david7lanci/traffic_light/arduino_video.pptx

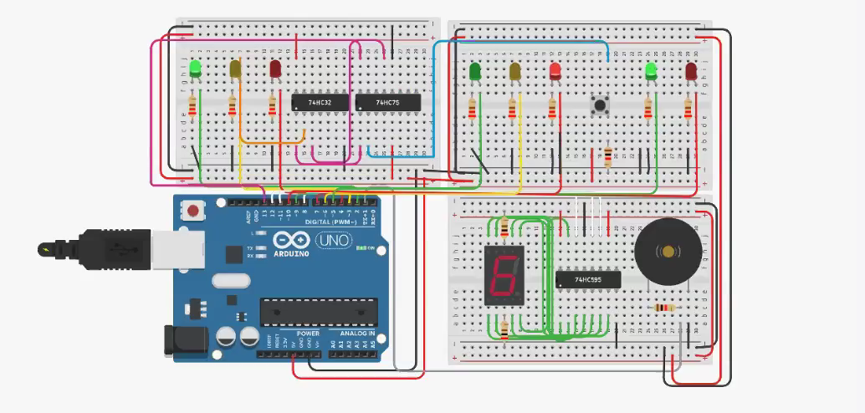
[picture p1: figure]
