david7lanci/traffic_light/book project.pdf

# קדם פרויקט

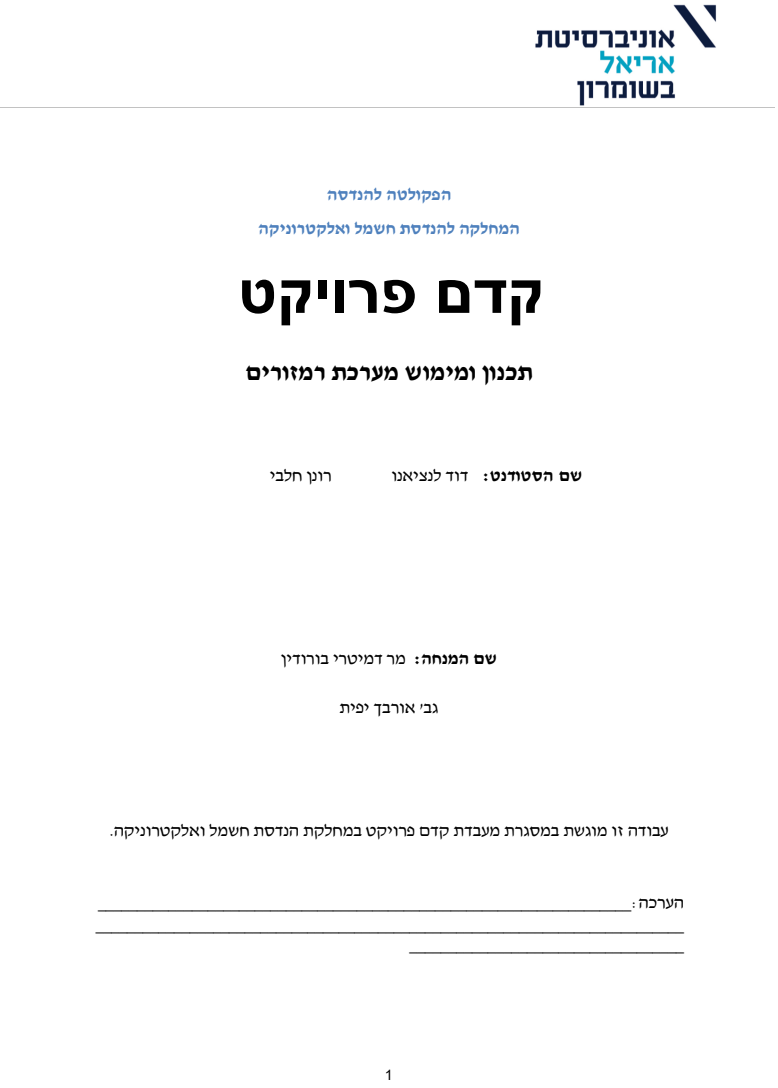
[picture p2: page 1]
הפקולטה להנדסה; הערכה:____________________________________________________________________ ___________________________________________________________________________ ___________________________________; daTg Thetford

המחלקה להנדסת חשמל ואלקטרוניקה

תכנון ומימוש מערכת רמזורים

שם הסטודנט: דוד לנציאנו רונן חלבי

שם המנחה: מר דמיטרי בורודין

גב' אורבך יפית

עבודה זו מוגשת במסגרת מעבדת קדם פרויקט במחלקת הנדסת חשמל ואלקטרוניקה.

### תוכן עניינים

16 | D-latch (NAND Gates) 4.4.1
18 | Seven segment 4.6.3
19 |

פרק :1 מבוא

1.1 רקע תיאורטי

רמזורים הם מערכת אורות צבעוניים המוצבת בצמתים, ותפקידם לווסת את התנועה בצומת. הרמזור הוא סוג של תמרור .
רמזורים לנסיעה למכוניות - לרמזורים למכוניות ישנם שלושה צבעים המסודרים אחד מעל השני)ירוק, צהוב ואדום(. האור הירוק מסמל שהנוסע רשאי לחצות את הצומת. האור הצהוב מסמל שהרמזור עומד להתחלף לאדום ולכן יש לפנות את הצומת והאור האדום מסמל לנוסע לעצור את נסיעתו ולא לעבור את הצומת. רמזורים להולכי רגל - רמזורים להולכי רגל עשויים להיות במצב המתיר חצייה, בזמן שגם מכוניות מסוימות מורשות לעבור. במצבים כאלו, זכות הקדימה נתונה להולכי הרגל. האור הירוק - מסמל שאפשר לחצות בעוד האור האדום - מסמל שאין לחצות.

איור .1רמזורים לנסיעה למכוניות.

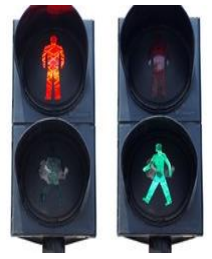
[picture p3: figure]

i | איור .2 רמזורים להולכי רגל

1.2 מדוע יש להפחית בעומסי התנועה ולמזער תאונות?

פקקי תנועה בישראל גורמים נזק של עשרות מיליארדי שקלים בשנה. בשנת 2016 העריכו משרד האוצר, משרד התחבורה וגופי התכנון כי פקקי תנועה עולים למשק 35 מיליארד ש"ח בשנה, וכי ללא שינוי המצב הקיים, העלות תגיע ל70- מיליארד ש"ח בשנה עד שנת .2040 כמות הנסועה בכלי רכב ממונעים )במיליוני ק"מ בשנה( לעומת אורך הכבישים בישראל )בק"מ(. עם השנים יש פער גדל בין כמות הנסועה לבין כמות הכבישים. הפער גדול יותר כאשר בודקים את היחס בין כמות הנסועה במכוניות לעומת כמות הכבישים העירוניים שבהם עיקר עומסי התנועה.
עומסי תנועה הן אחת ההשפעות החיצוניות היקרות והנפוצות של הרכב הפרטי, בישראל נהגים מבלים בפקקים מיליוני שעות עבודה ופנאי בשנה, דבר שפוגע הן ברווחה החברתית באופן ישיר, הן בהון החברתי והן בתוצר הכלכלי של המשק, בעלות של מיליארדי שקלים בשנה. בנוסף עומסי התנועה גורמים לאיחורים לא צפויים, מעלים את זיהום אוויר מתחבורה במיוחד במרכז הערים, גורמים לבלאי מואץ במכוניות ולבזבוז דלק, ותורמים לבעיות בריאות כמו מתח נפשי וגופני )סטרס(, כאבי גב וצוואר, התנהגות פרועה של נהגים עצבניים ) Road rage, נהגים שאיחרו ומנסים להגיע בזמן(, ולתת פעילות גופנית. באופן זה לפקקים יש השפעות גבוהות על רווחה חברתית בישראל והם מחריפים את משבר הבריאות בישראל על
ii | ידי תוספת של תחלואה, נכות ותמותה

1.3 הצורך בפתרון

הדרך שבה יהיה ניתן להפחית מעומסי התנועה הינה על ידי תכנון מערכת רמזורים אשר תהיה יציבה ובטיחותית כלפי המכוניות והולכי הרגל ואף שימושית לאנשים בעלי לקות ראייה.
הרמזור מהווה את אחד האמצעים החשובים לשפור זרימת התנועה ולקיום משטר תנועה תקין ובטוח.

פרק 2 :מטרת הפרויקט

מטרת הפרויקט הינה תכנון ומימוש של מערכת רמזורים לצומת T המתוארת באיור הבא:

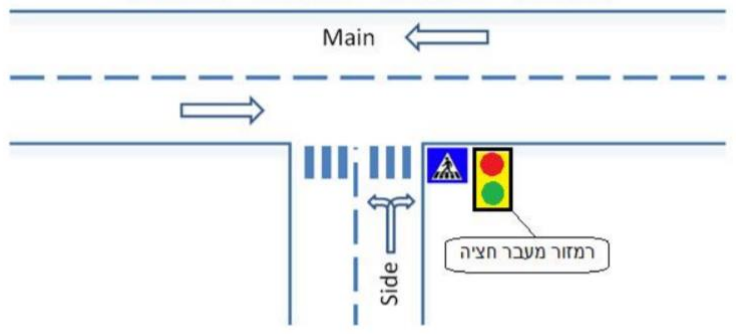
[picture p4: figure]

iii | איור .3 צומת הרמזורים

הצומת מורכבת משני צירים - ציר ראשי וציר משני הכולל מעבר חצייה להולכי רגל, כאשר הצירים כוללים שלושה רמזורים בהתאמה, העובדים במצבים המתוארים באיור 2)רמזור הולכי הרגל מתואם עם הרמזור המשני(.

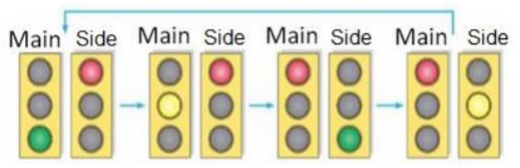
[picture p5: figure]

איור .4 מצבי הרמזורים הראשי והמשני.
המערכת כוללת תצוגה של ספירה לאחור עבור הולכי רגל וצפצוף בתדר משתנה לפי מצב הרמזור.

2.1 דרישות המערכת

- המערכת עוברת בין מצבים שונים בעלי אורך זמן משתנה.
- המערכת בעלת צפצוף בשני תדרים שונים במעבר הולכי רגל כדי לשמש אנשים בעלי לקות ראייה.
- צג זמן אשר מראה על ידי ספירה לאחור כמה זמן נותר להולך רגל לעבור את מעבר החצייה.
- המערכת צריכה להיות סינכרונית.
- מותקן במערכת לחצן תיעדוף להולכי רגל כאשר מוסיף להולך רגל 2 שניות נוספות לחצייה בטוחה.
- המערכת תפעיל את הלחצן רק בעת תחילת מחזור מצבים חדש.
- המערכת מאפשרת עצירה בטוחה של רכבים בעת המעבר בין המצבים.

2.2 תכנון וביצוע

- תכנון ובניית תצוגת המונה.
- תכנון ובניית שעון.
- תכנון ובניית מערכת בקרה סינכרונית.
- תכנון ובניית מחלק תדר.
- תכנון ובניית זמנן.
- תכנון ובניית לחצן תיעדוף.
- תכנון ובניית תאורת הרמזורים.

פרק :3 תיאור המערכת

3.1 דיאגרמת הבלוקים

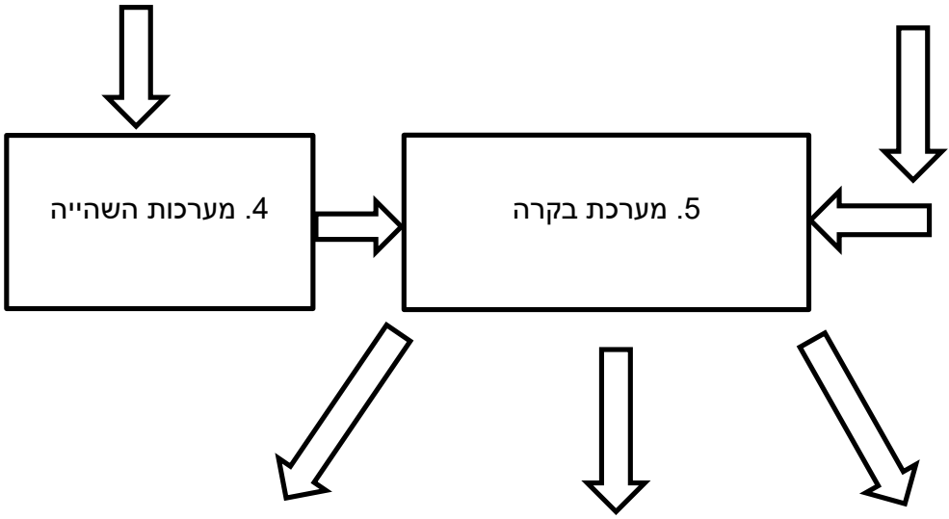
[picture p6: figure]
.5 מערכת בקרה; .4 מערכות השהייה

.9 זמזם תדר

.6 תצוגת רמזורים .7 צג מנייה

.1 שעון .3 לחצן התיעדוף
.2 ספק מתח

.8 מחלק תדר

.1 שעון
אחראי על סנכרון המערכת בעזרת שעון בודד.

.2 ספק מתח
מספק מתחי הזנה של [volt [5 לכלל הרכיבים והשערים של המערכת.

.3 לחצן תיעדוף
נועד לתת אינדיקציה למערכת ההשהייה מתי עליה לפעול.

.4 מערכת השהייה
ברגע שהיא מקבלת אינדיקציה מהלחצן תיעדוף ובתחילת המחזור הבא היא מבצעת השהייה של כשתי שניות למערכת.

.5 מערכת בקרה
למערכת זו ישנם מספר תפקידים: הפעלת תצוגת הרמזורים.
הפעלת התזמונים השונים בין המצבים. סנכרון בין המצבים השונים של המערכת. הפעלת מערכת ההשהיה רק ברגע תחילת מחזור חדש של המערכת ואיפוסה.

.6 תצוגת רמזורים
משמשת לתצוגת תאורה בצבעים שונים המתארים את מצבו של כל רמזור במערכת.

.7 צג מנייה

משמש לתצוגת כמה זמן ישנו להולך רגל לחצות את מעבר החצייה בספירה לאחור.

.8 מחלק תדר

משמש לחלוקת התדרים בכניסה לזמזם.

.9 זמזם תדר

משמש את ההולכי רגל בעלי לקות ראייה בכך שהוא מזמזם בשני תדרים שונים המתארים את שני המצבים השונים של רמזור ה הולכי רגל.

3.2 הסבר כללי על המערכת

במצב התחלתי הרמזור הראשי נמצא במצב ירוק ומאפשר זרימה תנועה בכביש הראשי, במקביל בכביש המשני הרמזור נמצא במצב אדום ולא מאפשר פניה ימינה או שמאלה של מכוניות, ובנוסף בזמן זה רמזור הולכי רגל מאפשר חציית הכביש תוך כדי השמעת צפצוף בתדר גבוה עבור הולכי רגל לקוי ראייה . לאחר פרק זמן של 6 שניות עובר הרמזור הראשי למצב ביניים )אור צהוב( למשך 3 שניות כדי לאפשר עצירה בטוחה של הרכבים , בזמן זה הרמזור המשני עדיין באדום ורמזור הולכי הרגל עובר לאדום והצפצוף עובר לתדר נמוך למשך כל פרק הזמן בו רמזור הולכי הרגל במצב אדום.
לאחר 3 שניות הרמזור הראשי עובר לאדום והמשני לירוק, רמזור הולכי הרגל נותר ללא שינוי למשך 8 שניות .לאחר פרק זמן של 6 שניות עובר הרמזור המשני למצב ביניים למשך 3 שניות כדי לאפשר עצירה בטוחה של הרכבים , בעוד הרמזור הראשי עדיין באדום . לאחר 3 שניות הרמזור המשני עובר לאדום והראשי לירוק ורמזור הולכי הרגל עובר לירוק עם צפצוף בתדר גבוה למשך כל פרק הזמן בו רמזור הולכי הרגל במצב ירוק . וחוזר חלילה . בנוסף ברמזור הולכי הרגל, ממוקם לחצן תיעדוף, ברגע שהולך רגל לוחץ על הלחצן, בפעם הבאה שהרמזור הראשי הופך למצב ירוק, הוא ימשך 8 שניות, כאשר ברמזור הולכי הרגל נשמע צפצוף בתדר גבוה למשך 8 שניות ומוצג זמן בתצוגה.

פרק :4 מימוש המערכת

4.1 שעון

אחראי על סנכרון המערכת בעזרת שעון בודד בנוי מרכיב cm555Lm . רכיב זה מכיל שני מגברי שרת המחוברים בתצורה של מגבר משווה, נגדים טרנזיסטורים ודלגלג. צורת החיבור של השעון מאפשרת cycle duty של 50% באופן כזה שנגד 2R זניח ביחס לנגד 1R על מנת שהזמן טעינה יהיה שווה לזמן הפריקה. המעגל מוזן ממתח של [v [5 כיוון שזהו מתח העבודה של הדלגלג בסימולציה. השעון שלנו צריך לעבוד בשניות אך, ישנה בעייתיות עם הסימולציה ולכן זמן המחזור של השעון בפועל הוא [Sec [m10 .

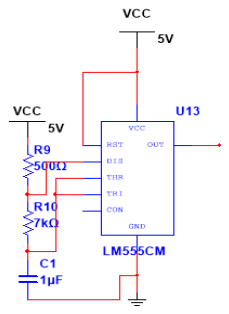
[picture p7: figure]

איור .5 שעון מבוסס cm555Lm
4.2 מחלק תדר

השימוש במחלק תדר הינו לטובת הזמזם של המערכת, אחת הדרישות של המערכת הייתה יעילות ללקויי ראייה על ידי צפצוף בשני תדרים שונים. באמצעות מחלק התדר, התדר חולק ב 4 על ידי מונה בינארי. בתורת המיתוג ,מונה הוא התקן אלקטרוני שסופר את מספר האירועים מסוג מסוים )לרוב אותות חשמליים( שקרו, בדרך כלל בהתאמה ל אותות שעון. מונים בנויים ממעגלי זיכרון כמו דלגלגים )פליפ פלופים( ובעזרת שיטות תיכון מגוונות. מונה סינכרוני, כמו שמתחייב משמו, כל אותות המוצא )הפלטים( של הפליפ פלופים משתנים
כאשר n הוא מספר הביטים במונה. במונה | −1 | על פי שעון יחיד. מונה זה יכול למנות עד 2
זה, הביטים מתעדכנים בעזרת מערכת של שערים לוגיים .דרך פשוטה ליישום )באמצעות השערים( הלוגיקה עבור כל ביט במונה סינכרוני עולה, היא לשנות את ערכו של כל ביט כאשר ערכם של כל הביטים הנמוכים ממנו הוא אחד. לדוגמה במונה בן ארבעה ביטים שנסמנם כביט ,0 ביט ,1 ביט 2 וביט ,3 ביט 1 משתנה כאשר ערכו של ביט 0 הוא אחד, ביט

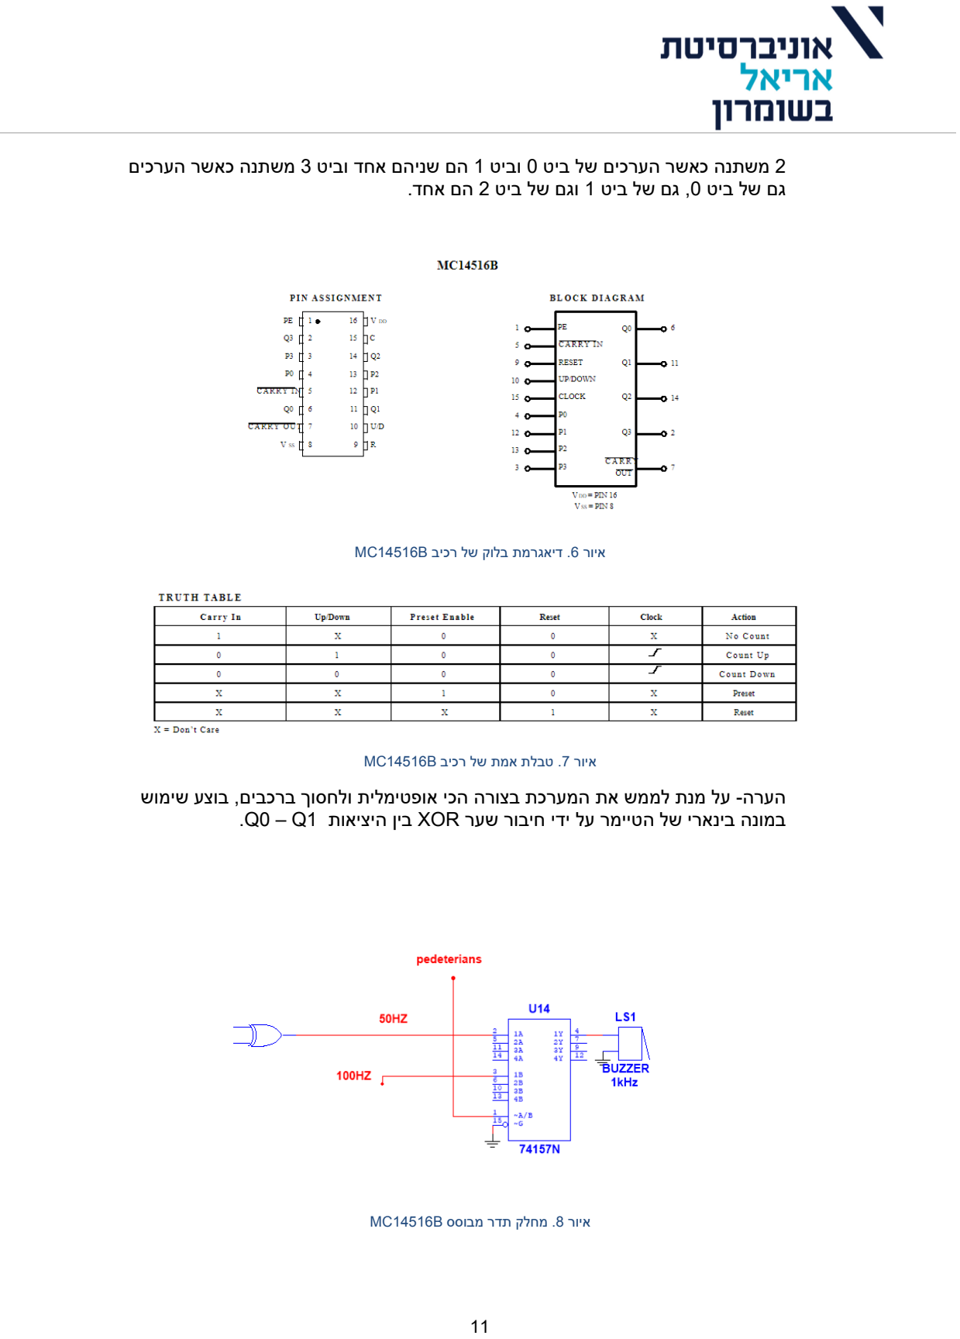
[picture p8: page 11]

2 משתנה כאשר הערכים של ביט 0 וביט 1 הם שניהם אחד וביט 3 משתנה כאשר הערכים גם של ביט ,0 גם של ביט 1 וגם של ביט 2 הם אחד.

איור .6 דיאגרמת בלוק של רכיב B14516MC

איור .7 טבלת אמת של רכיב B14516MC
הערה- על מנת לממש את המערכת בצורה הכי אופטימלית ולחסוך ברכבים, בוצע שימוש במונה בינארי של הטיימר על ידי חיבור שער XOR בין היציאות 1Q – 0Q.

איור .8 מחלק תדר מבוסס B14516MC

4.3 מערכת בקרה

הדרישה למערכת בקרה הייתה על מנת לתזמן את הרמזורים לפי הצירוף המבוקש. מערכת הבקרה שלנו הינה מערכת עקיבה סינכרונית מסוג mealy – שבה המוצאים הינם פונקציות של המצב הנוכחי והכניסות הנוכחיות. כלומר, מערכת צירופית עם זיכרון. ערכי הפלט תלויים בערכי הקלט וכן בתוכן הזיכרון של המערכת.

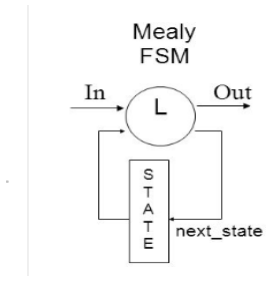
[picture p9: figure]

איור .9 מערכת עקיבה צירופית מסוג mealy

4.3.1 שלבי תכנון של מערכת בקרה

.1 הבנת הדרישות
.2 בניית דיאגרמת מצבים או טבלת מצבים .3 צמצום טבלת המצבים במידת הצורך .4 בחירת הקצאת המצבים ובחירת flop flip .5 טבלת מעברים ומוצא
.6 מימוש פונקציות עירור ופונקציות מוצא .7 שירטוט מימוש המערכת

טבלת מצבים:

| רמזור הולכי רגל רמזור משני רמזור ראשי מצבים
אדום ירוק התחלתי – [Sec [m6 | ירוק + צפצוף בתדר גבוה
אדום צהוב שני – [Sec [m3 | אדום + צפצוף בתדר נמוך
ירוק אדום שלישי – [Sec [m6 | אדום + צפצוף בתדר נמוך
צהוב אדום רביעי – [Sec [m3 | אדום + צפצוף בתדר נמוך

איור .10 טבלת מצבים של מערכת הבקרה

בנוסף יש לחצן להולכי רגל ברגע שלוחצים עליו, בפעם הבאה שהרמזור הראשי הופך לירוק, הוא יימשך ל 8 שניות, כאשר ברמזור הולכי רגל יישמע צפצוף בתדר גבוהה למשך 8 השניות.

בחירת הקצאת מצבים – דלגלג מסוג D:

במערכת זו ישנם ארבעה מצבים, כדי לממש זאת יש צורך בשני דלגלגים לאור העובדה
n- מספר הביטים( | | שדלגלג מקבל ביט אחד המייצג שני מצבים( 2

יציאות מצבים
A | B | Rm | Ym | Gm | Rs | Ys | Gs | Rz | Gz
0 | 0 | 0 | 0 | 1 | 1 | 0 | 0 | 0 | 1
0 | 1 | 0 | 1 | 0 | 1 | 0 | 0 | 1 | 0
1 | 0 | 1 | 0 | 0 | 0 | 0 | 1 | 1 | 0
1 | 1 | 1 | 0 | 0 | 0 | 1 | 0 | 1 | 0
איור .11 טבלת יציאות המערכת כתלות במצבים השונים

במעגל שלנו ישנם שתי כניסות, לחצן תיעדוף וtimer . כאשר מטרת השעון הינה לתזמן את מצבי המערכת, כולל את ההשהיות והמעבר בין המצבים.

רישום טבלת מעברים ויציאות:

NS
TIMER
p.s | 0 | 1
00 | 00 | 01
01 | 01 | 10
10 | 10 | 11
11 | 11 | 00
Present state =y1 and y2, Next State = Y1 and Y2

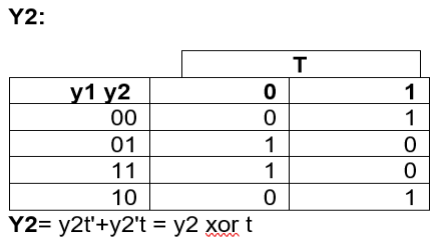
[picture p10: figure]

Green main:

y2

y1 | 0 | 1
0 | 1 | 0
1 | 0 | 0

y1'y2'

Yellow main:

| | y2
y1 | 0 | 1
0 | 0 | 1
1 | 0 | 0

y1'y2

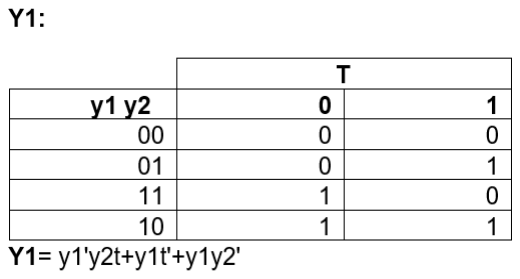
[picture p11: figure]

Red main:

y2

y1 | 0 | 1
0 | 0 | 0
1 | 1 | 1

y1

Green side:

| | y2
y1 | 0 | 1
0 | 0 | 0
1 | 1 | 0

y1y2'

TIMER
0 1
y1 | y2 | Y1 | Y2
0 | 0 | 00 | 01
0 | 1 | 01 | 10
1 | 0 | 10 | 11
1 | 1 | 11 | 00

yellow side:
y2
y1 | 0 | 1
0 | 0 | 0
1 | 0 | 1

y1y2

Red side:
| y2
y1 | 0 | 1
0 | 1 | 1
1 | 0 | 0

y1'

Green pedestrians:
y2
y1 | 0 | 1
0 | 1 | 0
1 | 0 | 0

y1'y2'

Red pedestrians:
y2
y1 | 0 | 1
0 | 0 | 1
1 | 1 | 1

y1+y

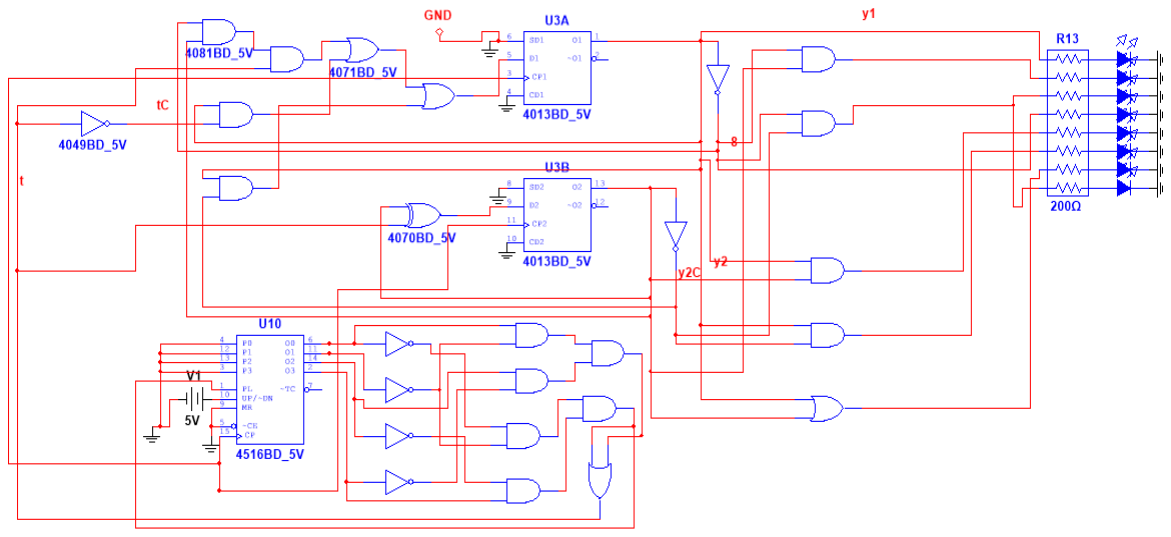
[picture p12: figure]

איור .12 מערכת בקרה בשלמותה

4.3.2 זמנן
כניסת הtimer( זמנן( ממומשת על ידי פונקציות בוליאניות בעלות חלוקת זמנים שונה, המשתנים של הפונקציות הינם היציאות של מונה בינארי המוזן מהשעון הכללי של המערכת. כאשר המונה הינו מונה מעלה. הפונקציות מתוארות להלן:

t6 = Q3'Q2Q1'Q0
t3 = Q3Q2'Q1'Q0'
t = t6 or t3

4.4 לחצן תיעדוף

D-latch (NAND Gates) 4.4.1

מעגל זה יכול לתפקד כ- LATCH-D או כ- R-S על מנת להגדיר את המעגל כ- LATCH-D יש על הכניסות SET ו-RESET להיות ב" 1" לוגי. על מנת להגדיר את הרכיב כSR יש לקבוע את כניסת האפשור ו ה-D בערך לוגי קבוע. במעגל שלנו במצב התחלתי כניסות אלה מוזנות ב " 1" לוגי, אך כאשר התנאי של ההשהיה מתקיים רגל ה RESET מקבלת פולס של " 0" לוגי על מנת לאפס את הנועל. רגל D במערכת שלנו מחוברת ללחצן וכאשר היא מקבלת " 1" לוגי , היא יודעת לשמור את הערך עד לאיפוס המעגל על ידי הרגל RESET. הערה: הרכיב ממומש באמצעות שערים לוגיים לאור הצורך בתצוגה תלת ממדית.

E | SET | Reset | D | Q | Q
X | 0 | 0 | X | 1 | 1
X | 0 | 1 | X | 0 | 1
X | 1 | 0 | X | 1 | 0
1 | 1 | 1 | 1 | 1 | 0
0 | 1 | 1 | 0 | 0 | 1
איור .13 טבלת אמת של Latch .D

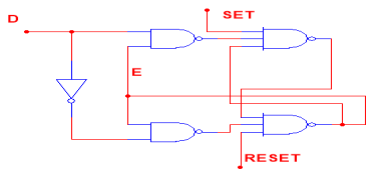
[picture p13: figure]

איור .14 מעגל המבוסס Latch .D

4.5 מערכת ההשהיה

4.5.1 חד יציב B14538MC

הרכיב B14538MC הינו חד יציב המורכב משני יחידות עצמאיות של רב-רטט. אופן הפעולה: הרכיב מקבל פולס כלשהו באחת הכניסות )דרבון(, וכתגובה לאות הכניסה-מוציא פולס ברוחב τ שאותו ניתן לקבוע מראש ע"י הנגד והקבל: RxCx =τ. הרכיב ניתן להפעלה בשתי דרכים: חיבור בדרבון חוזר, חיבור בדרבון לא חוזר. חיבור בדרבון חוזר- במידה וניתן פולס נוסף בכניסה טרם סיום האות במוצא- זמן ה-T ייחל להיספר מחדש.
למשל- אם הדלקנו את האור בחדר מדרגות, ולאחר 10 שניות לחצנו על הלחצן שנית- האור יידלק למשך 40 שניות סה"כ.
חיבור בדרבון לא חוזר- אין משמעות ללחיצה חוזרת טרם סיום זמן τ.

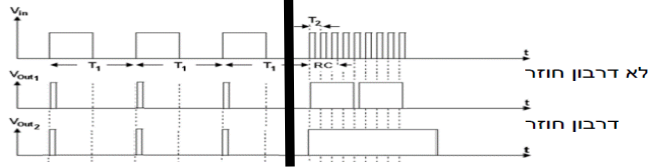
[picture p14: figure]

איור .15 גרף המתאר אות מוצא כתלות באות הכניסה ובסוג הדרבון

בכל אחד מאופני החיבור )דרבון חוזר/לא חוזר( ישנן 2 אפשרויות: פולס הטריגר ייקבע בעליית שעון, או בירידת שעון: במערכת זו החד יציב מחובר בצורה של פעיל בירידה ללא דרבון חוזר, ואת הדרבון בכניסה הרכיב מקבל כאשר מתקיימים התנאים הבאים: .1 לחצן התיעדוף מתוזמן.
.2 רמזור ההולכי רגל בירוק. .3 טיימר פעיל.
.4 שעון בעלייה.
הרוחב פולס הינו ברוחב של כשתי שניות ביחס למערכת.

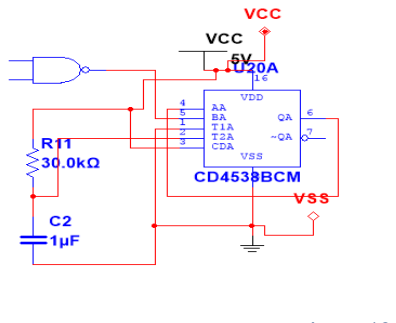
[picture p15: figure]

איור .16 מעגל השהייה המבוסס רכיב B4538CD

4.6 מערכת תצוגה

4.6.1 מונה בינארי
מונה הוא התקן אלקטרוני שסופר מספר אירועים מסוג מסוים אשר קרו. בדרך כלל בהתאמה לאותות שעון )ירידה ועליה של אות שעון (, במערכת זו נעשה שימוש במונה B4516CD המונה מטה החל מערך המשתנה כתלות בלחצן התיעדוף- כאשר לחצן התיעדוף אינו לחוץ הוא מתחיל את המנייה מ הספרה ,6 וכאשר הלחצן תיעדוף לחוץ הוא מתחיל את המנייה מספרה .8
המונה במערכת זו עובד בצורה מסונכרנת עם רמזור הולכי הרגל)המונה יעבוד רק כאשר הרמזור ירוק( והשעון הכללי של המערכת.

4.6.2 קוד עשרוני BCD

עשרוני בקידוד בינארי )הידוע יותר בראשי התיבות Decimal Coded Binary - BCD ( היא דרך הקידוד הנפוצה ביותר של ספרות עשרוניות במחשבים ובמערכות אלקטרוניות . כל ספרה עשרונית מיוצגת על ידי 4 סיביות ,כאשר ערכן של הסיביות מימין לשמאל הוא 1,2,4 ולבסוף .8 זהו מספר הסיביות המינימלי שיכול לייצג באופן בינארי את כל הספרות מ־ 0 עד .9

Seven segment 4.6.3

זהו רכיב המורכב משמונה דיודות LED היכולות להציג את 10 הספרות הבסיסיות 0-9 בהצגה עשרונית על פי העיקרון שכל רגל כניסה של הרכיב מייצגת דיודת LED אחת. התקני ה-segment Seven מחולקים לשתי קבוצות : אנודה משותפת )anode Common – )כל הדיודות מחוברות ל-VDD באנודה שלהם על מנת שהמקטעים ידלקו, הקתודה של הדיודה צריכה לקבל 0 לוגי, כאשר הקתודה מקבל 1 לוגי המקטע נכבה. במערכת זה נעשה שימוש בקבוצה זו.

קתודה משותפת )cathode Common – )כל הדיודות מחוברות לאדמה בקתודה שלהם על מנת שהמקטעים ידלקו, האנודה צריכה לקבל 1 לוגי, כאשר הקתודה מקבל " 0" לוגי המקטע נכבה.

איור .18 טבלה המתארת את חיבורי הרגליים לצג

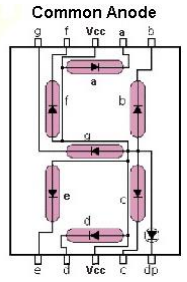
[picture p16: figure]

4.6.4 חישוב מערכת הגנה לדיודות

בין הרכיב segment Seven לרכיב segment Seven to BCD יש לשים נגד הגנה בטור לדיודה כדי שהדיודות לא ישרפו במהלך הדלקתם בזרם גבוה מדי. על מנת לחשב את הנגד המינימלי שניתן לחבר הוכנס מתח כניסה של [v [5 ומתוך דפי הנתונים של segment Seven נתון שהמתח הנופל על דיודת LED אדומה הוא V3.45 והזרם המקסימלי הזורם עליה הוא mA,20 הנגד המינימלי חושב על פי נוסחה 1

R

VDD − VD
ID

= 5 − 3.45
20m = 77.5[Ω]min

מתוך הערך המינימלי של הנגד הוחלט להשתמש בנגד של Ω100 עבור כל LED של ה segment Seven. סך הכל שבעה נגדים עבור התצוגה G-A .

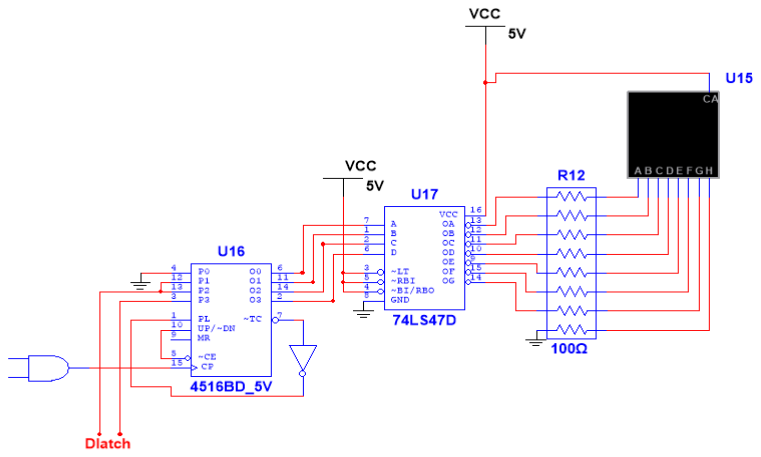
[picture p17: figure]

איור .19 מערכת תצוגה בשלמותה

| רגל LED
E | 1
D | 2
C | 4
DP | 5
B | 6
A | 7
F | 9
G | 10

איור .17 סכמת המתארת את חיבור רגליים בצג

פרק 5 : תוצאות ומסקנות

5.1 תוצאות הפעלת המערכת

תחילה יש לציין שהמערכת תוכננה באמצעות Multisim שהינה תוכנה נוחה ושימושית לביצוע סימולציות של מעגלים חשמליים שונים, המערכת לא מומשה בפועל לאור דרישות הקורס תחת תנאים מיוחדים.
המערכת הופעלה במלואה, וישנם תופעות מעבר בזמן המנייה של המצב הראשון מופיע בצג 8 שניות במקום 6 שניות כתוצאה מתוכנת הסימולציה. להלן המערכת במלואה:

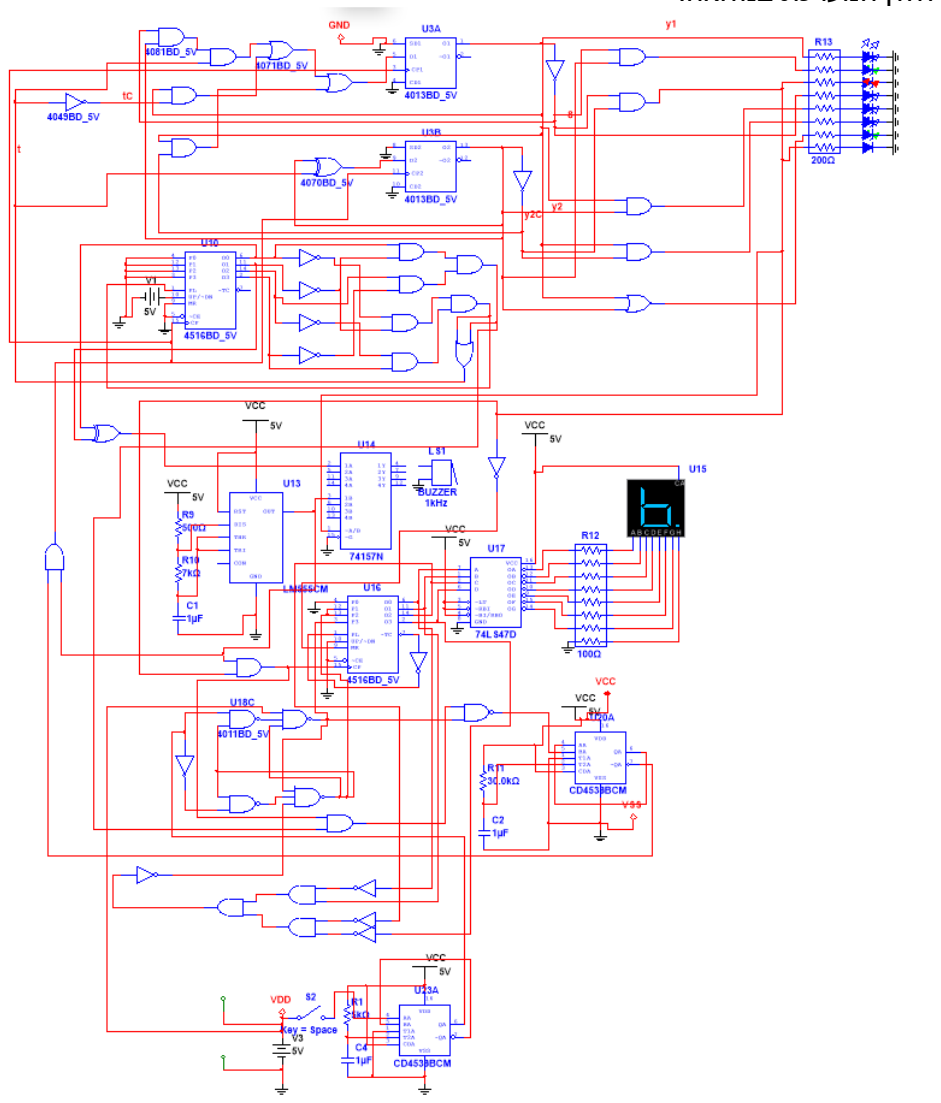
[picture p18: figure]

איור .20 מערכת צומת רמזורים בשלמותה

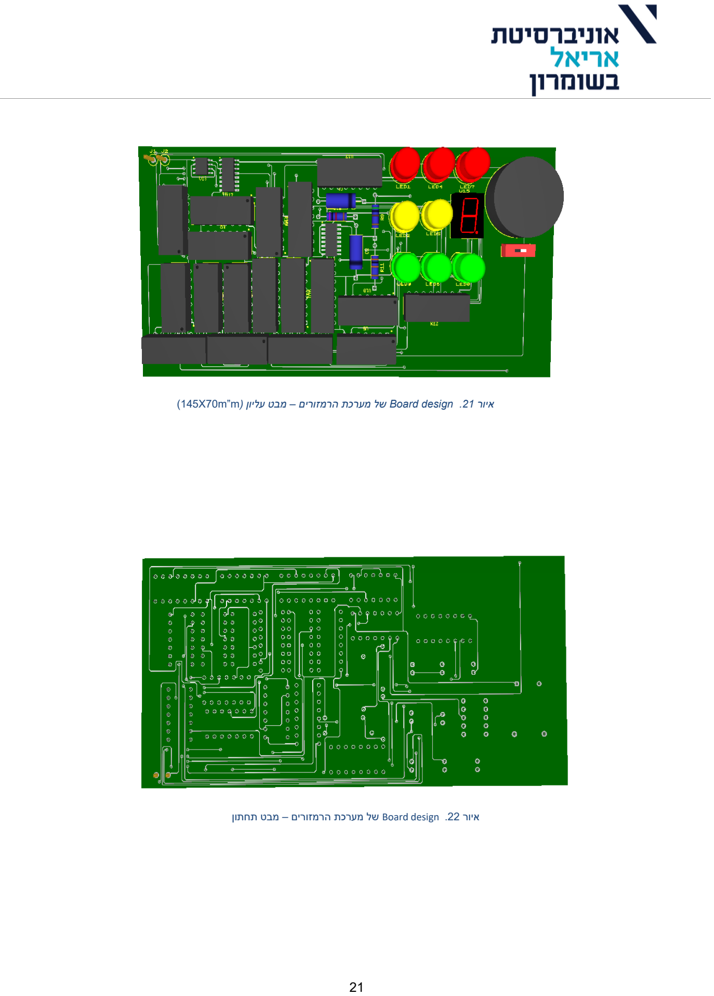
[picture p19: page 21]

איור .21 design Board של מערכת הרמזורים – מבט עליון )m”m70X145 )

איור .22 design Board של מערכת הרמזורים – מבט תחתון

התוצאה שהתקבלה במדידת ה TIMER כפי שניתן לראות באיורים )23-25( הינה מדויקת עבור הפעלת כלל המצבים )כאמור לעיל [sec[m10מייצג שניה אחת(.

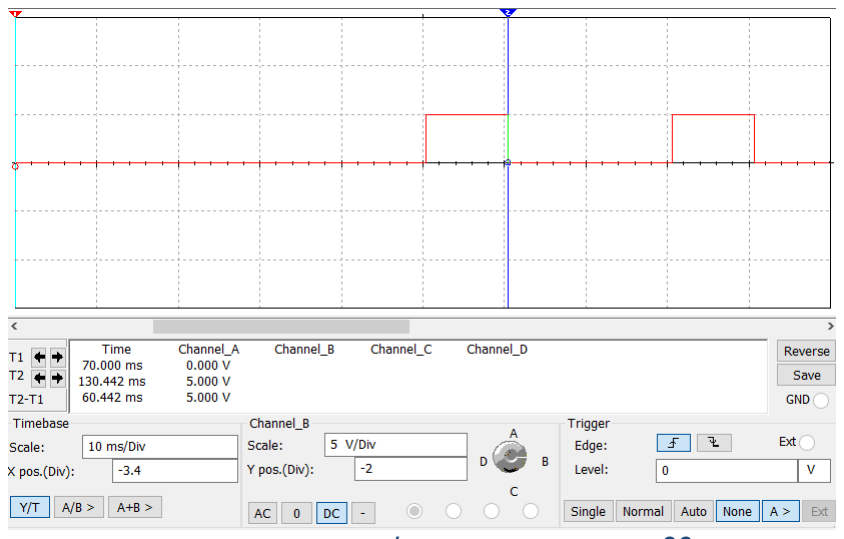
[picture p20: figure]

איור .23 מדידת מתח המוצא של הזמנן עבור המצב הראשון

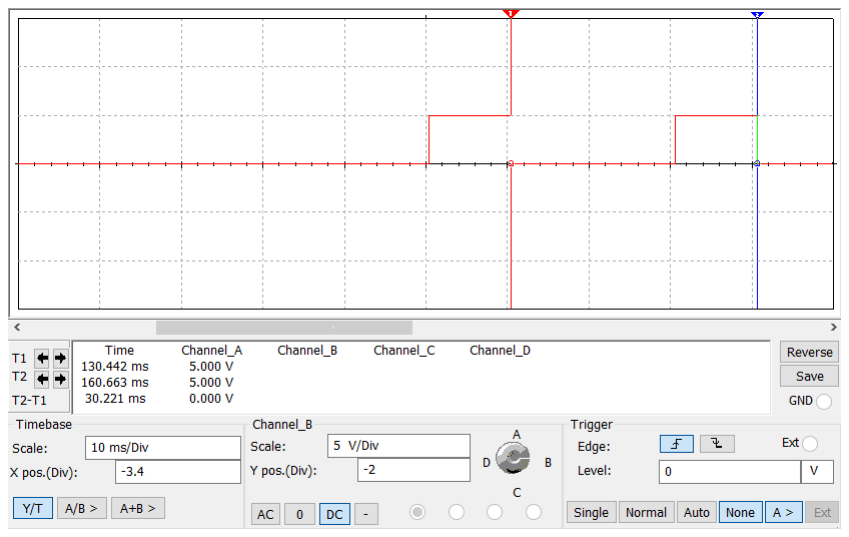
[picture p21: figure]

איור .24 מדידת מתח המוצא של הזמנן עבור המצב השני

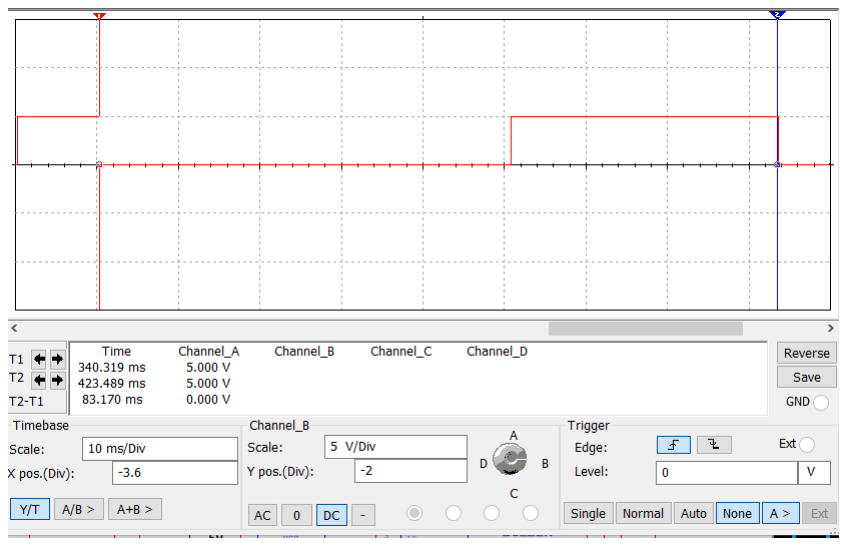
[picture p22: figure]

איור .25 מדידת מתח המוצא של הזמנן עבור מצב לחצן התיעדוף

תוצאות מדידה עבור המחלק תדר בכניסה לזמזם, כפי שניתן ניתן לראות באיורים )26-27( שהתדר חולק ב .4

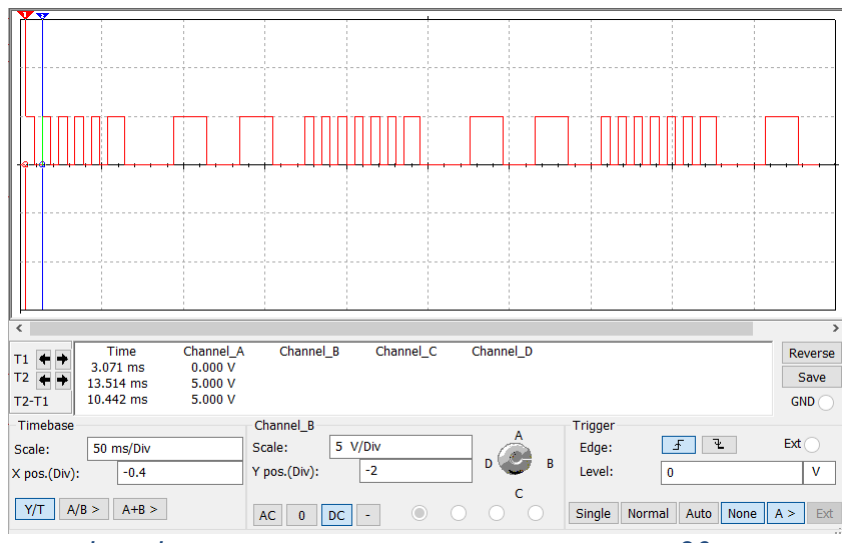
[picture p23: figure]

איור .26 מדידת תדר המוצא עבור אור ירוק ברמזור הולכי רגל

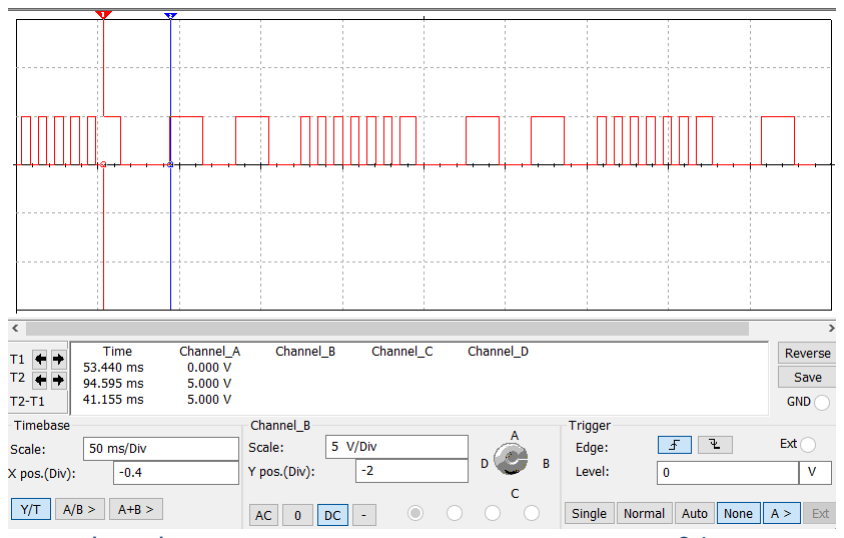
[picture p24: figure]

איור .24 מדידת תדר המוצא עבור אור אדום ברמזור הולכי רגל
תוצאות המדידה באיור 25 מרגע השימוש בלחצן תיעדוף וקליטתו במערכת הזיכרון ועד הפעלת ההשהיה של כשתי שניות בעת תחילת המחזור הבא, ואיפוס מערכת הזיכרון לאחר המימוש.

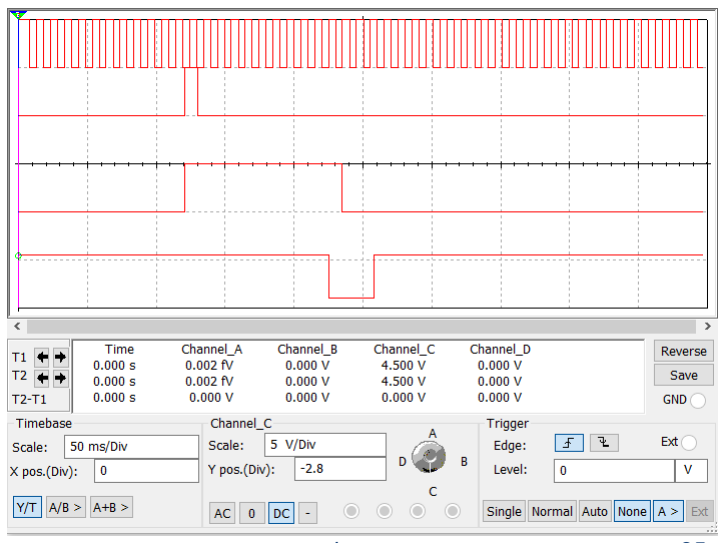
[picture p25: figure]

איור .25 מתח מוצא מערכת ההשהייה מרגע לחיצה ועד ביצוע ההשהייה במצב הדרוש
5.2 מימוש והפעלת המערכת עבור בקר Arduino

אַ רְ דּואִ ינֹו- הוא מיקרו-בקר בעל מעגל מודפס יחיד )Controller Micro Board Single), עם סביבת פיתוח משולבת )IDE )ברישיון קוד פתוח, אשר מטרתה ליצור סביבה נוחה וזולה לפיתוח פרויקטים המשלבים תוכנה עם רכיבי אלקטרוניקה.

המערכת מומשה באמצעות סימולטור(Card Tinker (הכולל הרכבת מעגל חשמלי וכתיבה קוד באמצעות שפת c.

Clock

P.B

D.Latch

Mono
stable

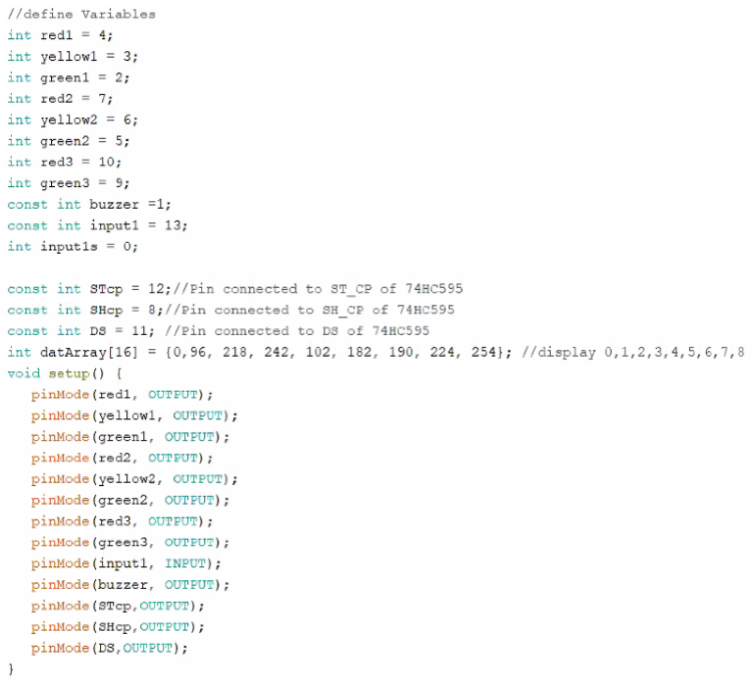
[picture p26: figure]

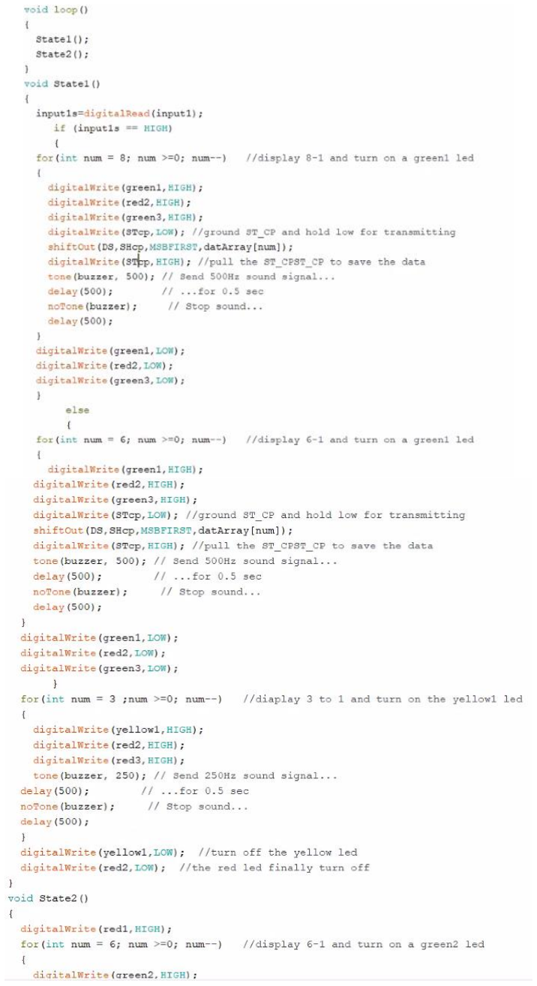
[picture p27: figure]

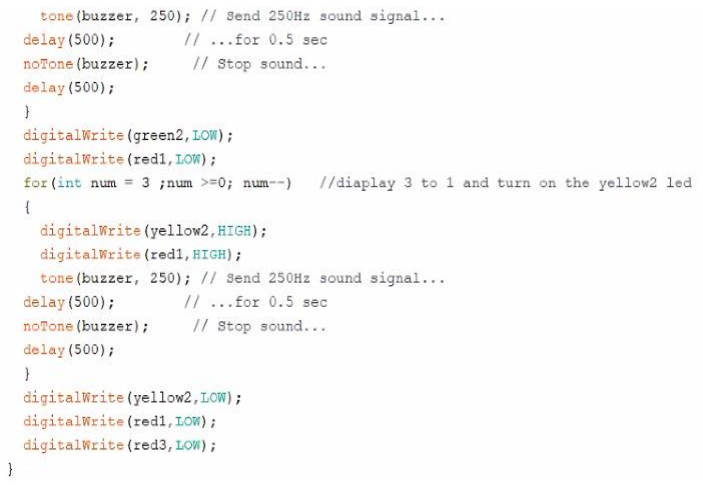
[picture p28: figure]
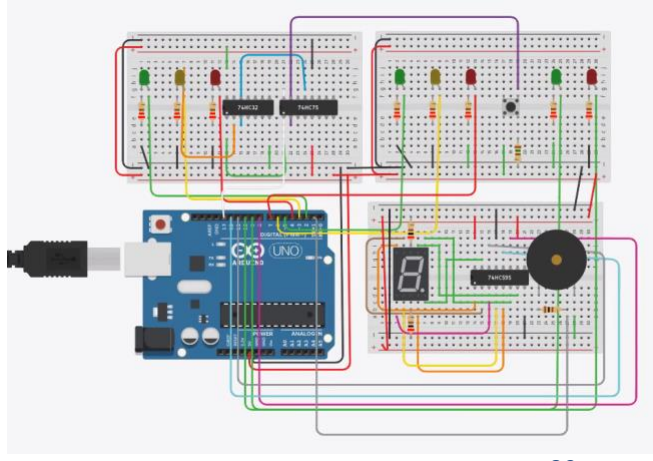
[picture p29: figure]

איור .26 מימוש המערכת באמצעות בקר Arduino

5.3 בעיות ופתרונות

שעון

בעיה- בעת התכנון של השעון ה CYCLE DUTY לא היה על .50%

פתרון- הבעיה נבעה מהעובדה שהיה הפרש יחס גדול בין הנגדים האחראים על הטעינה והפריקה של הקבל, הבעיה נפתרה בכך שערכו של הנגד 9R נקבע לערך זניח ביחס לנגד 10R ובכך התקבלו זמני טעינה ופריקה שווים.

מערכת בקרה

בעיה- המערכת בקרה בנויה מ רכיבי זיכרון מסוג FF D, המקבלים מידע מהזמנן מצבים. השינוי של הזמנים התקיים בעת עליית השעון של הדלגלג ולכן לא הייתה שליטה על המידע הנדגם ועקב כך המערכת לא הייתה יציבה.

פתרון- הפתרון של דגימת המידע הינו על ידי דיוק ב time hold and setup, אשר הושגו באמצעות הזזת והגדלת פולסי המידע של הזמנן.

כתוצאה מכך המערכת דגמה את המידע הרצוי בצורה יציבה ומדויקת.

לחצן תיעדוף ומערכת השהייה

בעיה- מערכת השהייה מחוברת לכניסות השעון של כלל רכיבי המערכת בקרה, כאשר בעת הפעלתה היא פעלה בצורה מסונכרנת לאותות מידע הנכנסים ל דלגלגים, ומכאן לא הייתה שליטה על המידע הנדגם ועקב כך המערכת לא הייתה יציבה.

פתרון- הפולס הורחב ל 3 שניות במקום שתי שניות, אשר סיפק למערכת מרחב time hold שנתן שליטה על דגימת המידע. הרחבת הפולס לא השפיעה על זמן ההשהיה הנדרש.

בעיה- בעת שמצב הלחצן תיעדוף התקיים, המערכת זיכרון של הלחצן התאפסה בתחילה המצב וכתוצאה מכך התאפשרה קבלת לחיצות נוספות אשר גרמו לחזרה נוספת על המצב.

פתרון- מומשה פונקציה לוגית אשר קיימה תנאים לאיפוס המערכת זיכרון בסוף קיום המצב, מכאן המערכת חסמה כל שימוש לא רצוי בלחצן.

צג מנייה

בעיה- מערכת הצג מנייה פעלה באופן רצוף, אשר הדבר לא ענה על דרישות הלקוח.

פתרון- מומשה פונקציה לוגית אשר הפעילה את המערכת בצורה מסונכרנת עם השעון הכללי, והמצב הרצוי להפעלת הצג.

5.4 מסקנות הפרויקט

בעת תכנון ומימוש המערכת התקבלו המסקנות הבאות:

- בעת תכנון מערכת, יש לחלק את העבודה לשלבים ולתכנן כל חלק בנפרד ולאחר מכן לסכם הכל ביחד כמערכת אחת.
- בעבודה עם דלגלגים יש לקחת בחשבון את הזמנים הבאים:

time Setup – הכניסות לרכיב חייבות להיות חוקיות לפחות ts לפני מופע השעון. time Hold- הזמן שבו הכניסות של הרכיב חייבות להישמר בערכים חוקיים אחרי מופע השעון.

אחרת לא ניתן לדעת איזה מידע הדלגלג דוגם בכניסותיו ובכך המערכת לא תהיה יציבה.

- בעבודה עם רכיבי דיודות למיניהם יש לקחת בחשבון הוספת נגד הגנה בטור על מנת שהדיודות לא יישרפו עקב עומס.

- רכיב הנועל הינו רכיב אשר עובד ללא שעון כלל ומוציא את המוצאים שלו לפי טבלת האמת, אך לעומתו הדלגלג הינו רכיב אשר מסונכרן עם שעון.
- כאשר עובדים עם חד יציב יש לקחת בחשבון את זמן הטעינה של הקבל ביחס למחזור אות הדרבון.
- בעת קביעת תנאי עבודה לרכיב כלשהו, יש לשים לב שהתנאים אינם מתנגשים אחד עם השני )למשל - במערכת שלנו תנאי אפשור הלחצן תיעדוף והמערכת השהייה אינם יכולים להיות מופעלים מאותו תנאי, אחרת המערכת לא תהיה יציבה(.
- כדי לבנות כרטיס (Design Board (אופטימלי, יש לנצל בהרכבת המעגל בסימולטור את כל רגלי הרכיבים, על ידי חלוקה למשפחות שערים (section ( אופטימלית .

.6סיכום

בפרויקט זה תוכננה צומת רמזורים בטוחה ונגישה להולכי רגל וללקויי ראייה בפרט. המערכת תוכננה בצורה לוגית וגם באמצעות בקר Arduino. מימוש באמצעות טכנולוגית ה Arduino פשוט וקל לתכנון, לעומת מימוש באמצעות תכנון לוגי אשר דרש עבודה מורכבת ומאתגרת חשיבתית, וזה ניקר כאשר המעגלים סוכמו כמערכת אחת.
בתכן לוגי היה לנו קשה לסנכרן את כל הרכיבים כאחד)תזמונים ושעונים( לעומת הארדואינו שתופעות אלה לא קיימות. כמו כן, בעת מימוש תנאים בתכן לוגי באמצעות רכיבים ופונקציות היה לנו מאתגר ליישם תנאים אלו בלי לפגוע ביציבות המערכת לעומת כתיבת קוד פשוט ויציב בארדואינו .

### .7מקורות

הרצאות טכניון, פרופסור אהרון אהרון -

https://www.youtube.com/watch?v=kY2OPQhckj4

ספר לימוד - א. אהרון: "תכן לוגי", "האוניברסיטה הפתוחה .1989

קורס מעבדת אלקטרוניקה 2 - "אוניברסיטת אריאל בשומרון" .

i https://sites.google.com/site/yuliaavezov84/23iihttps://ecowiki.org.il/wiki/%D7%A4%D7%A7%D7%A7%D7%99_%D7%AA%D7%A0%D7%95%D7%A2%D7%94_%D7%91%D7%99%D7%A9%D7%A8%D7%90%D7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

קורס קדם פרוייקט – קובץ הנחיות "מימוש ותכנון מערכת רמזורים" iii
